pelestedt/NTJ-Locomotive-Control/NTJ-Decoder-PCB/20211014_154324.jpg

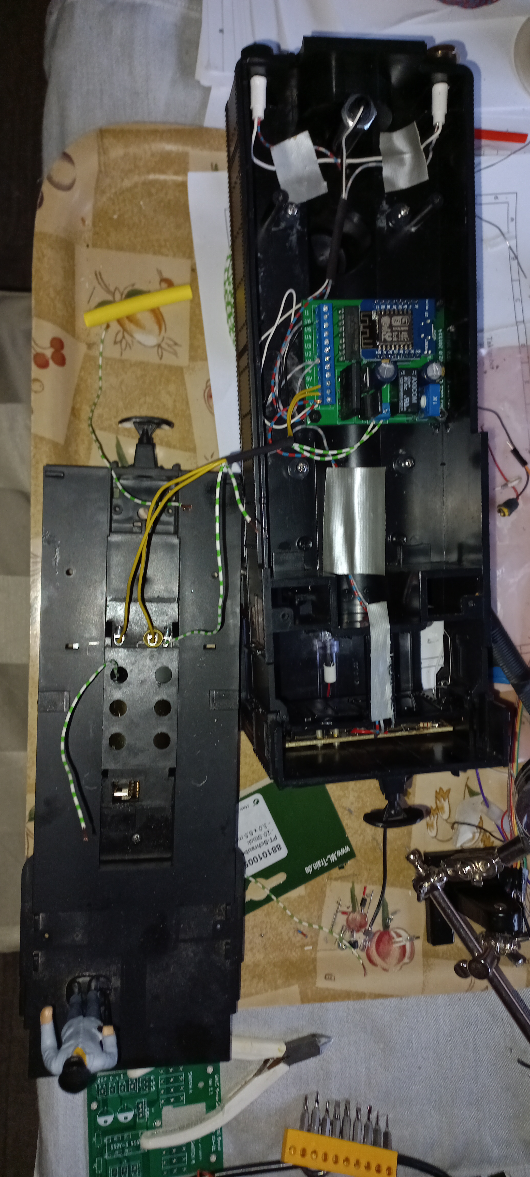
NTJ-Decoder-PCB/20211014_154324.jpg
