pelestedt/NTJ-Locomotive-Control/NTJ_analog_decoder/Inkopppling analogdekoder.pptx

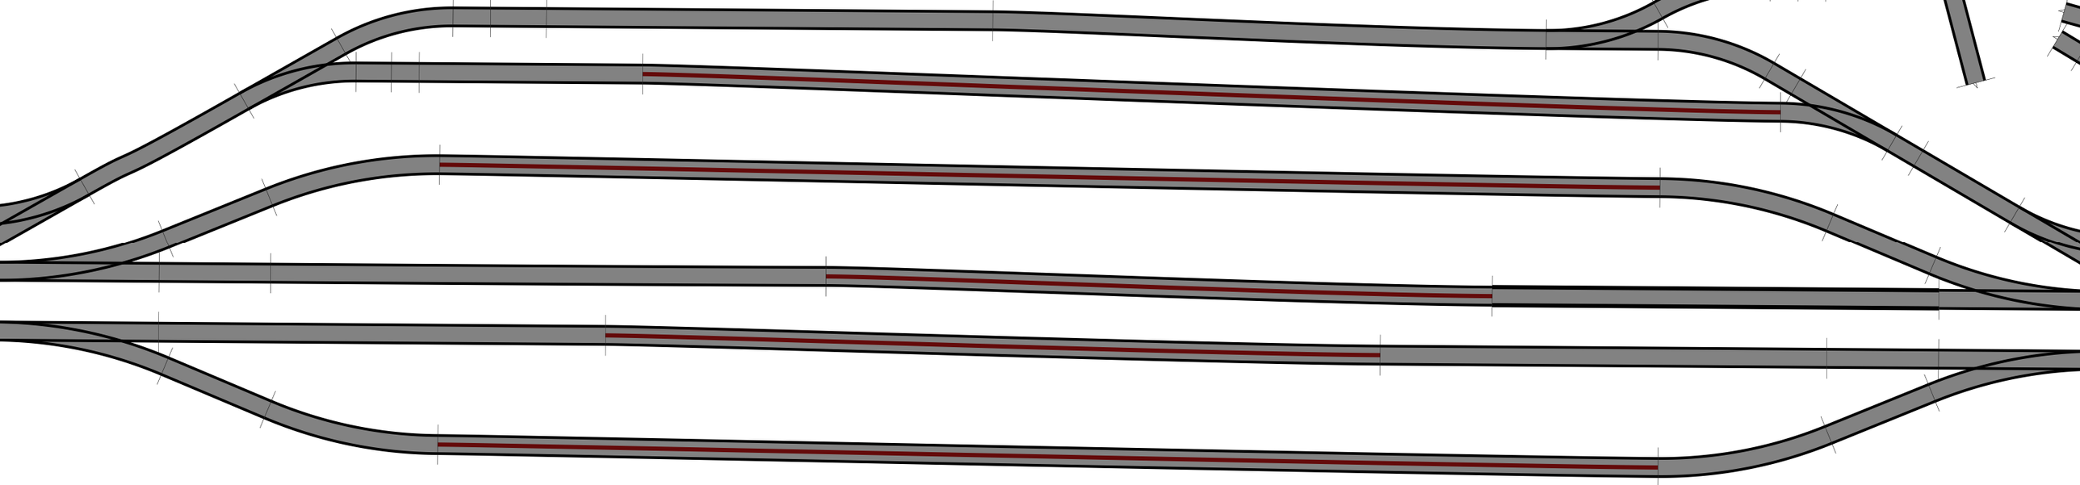
[picture p2: figure]

## Slide 2

220VAC

PSU 22VDC

22VDC

Step down 7VDC

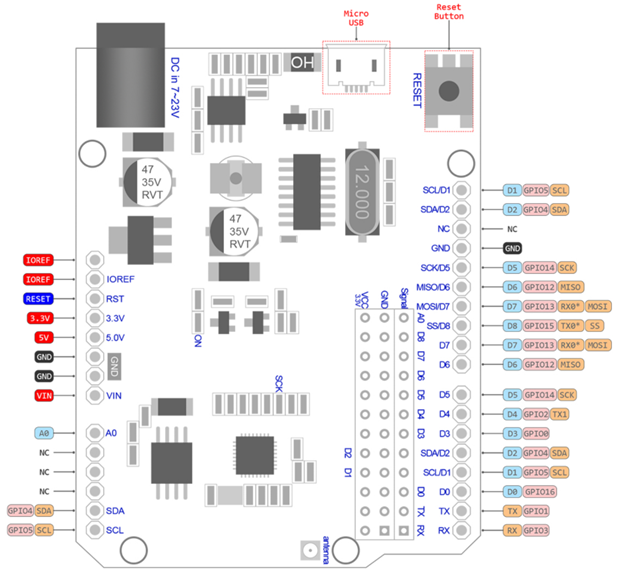
[picture p3: figure]
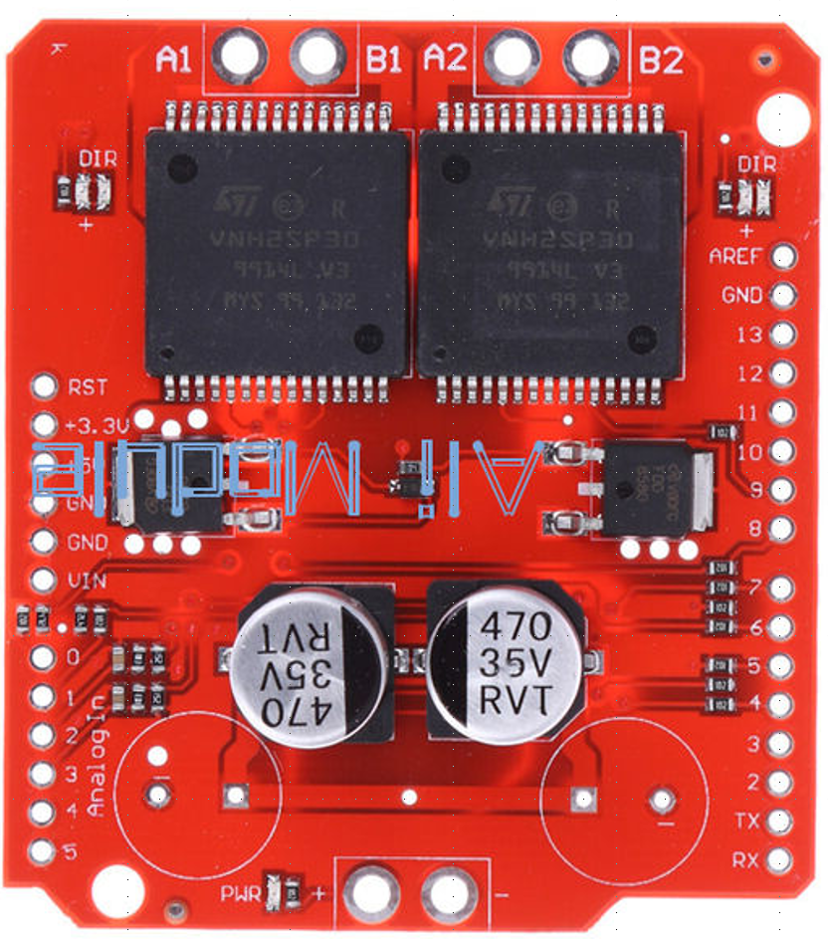
[picture p4: figure]

UT A

UT B

## Slide 3

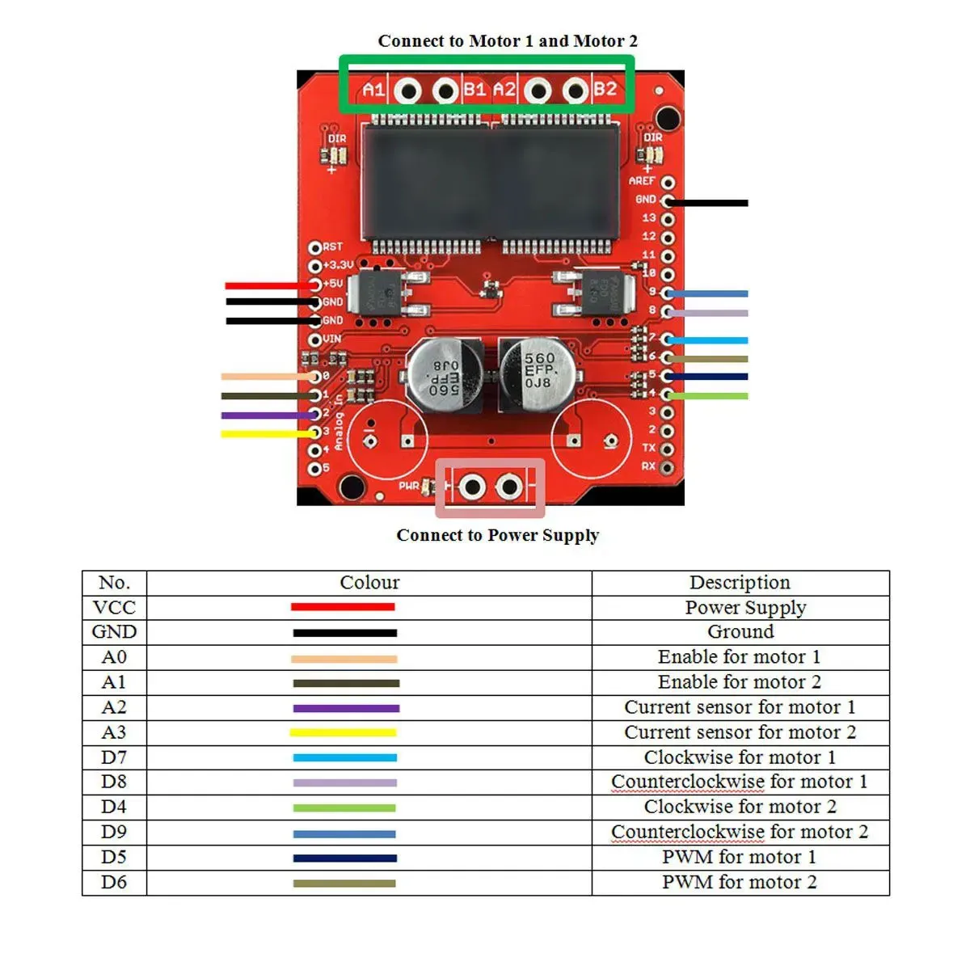
[picture p5: figure]

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
Relä 3

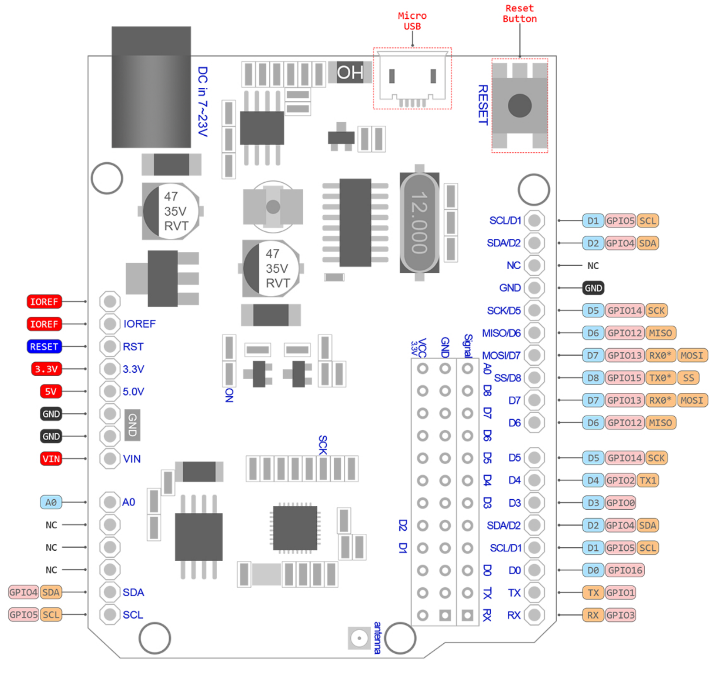
[picture p6: figure]

Relä 4

Relä 2

Relä 1

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
PWMa
PWMb

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
PWMa
PWMb
