pelestedt/NTJ-Locomotive-Control/NTJ-Decoder-PCB/Lokstyrning.kicad_pcb

## KiCad design NTJ-Decoder-PCB/Lokstyrning.kicad_pcb (2024-12-29)

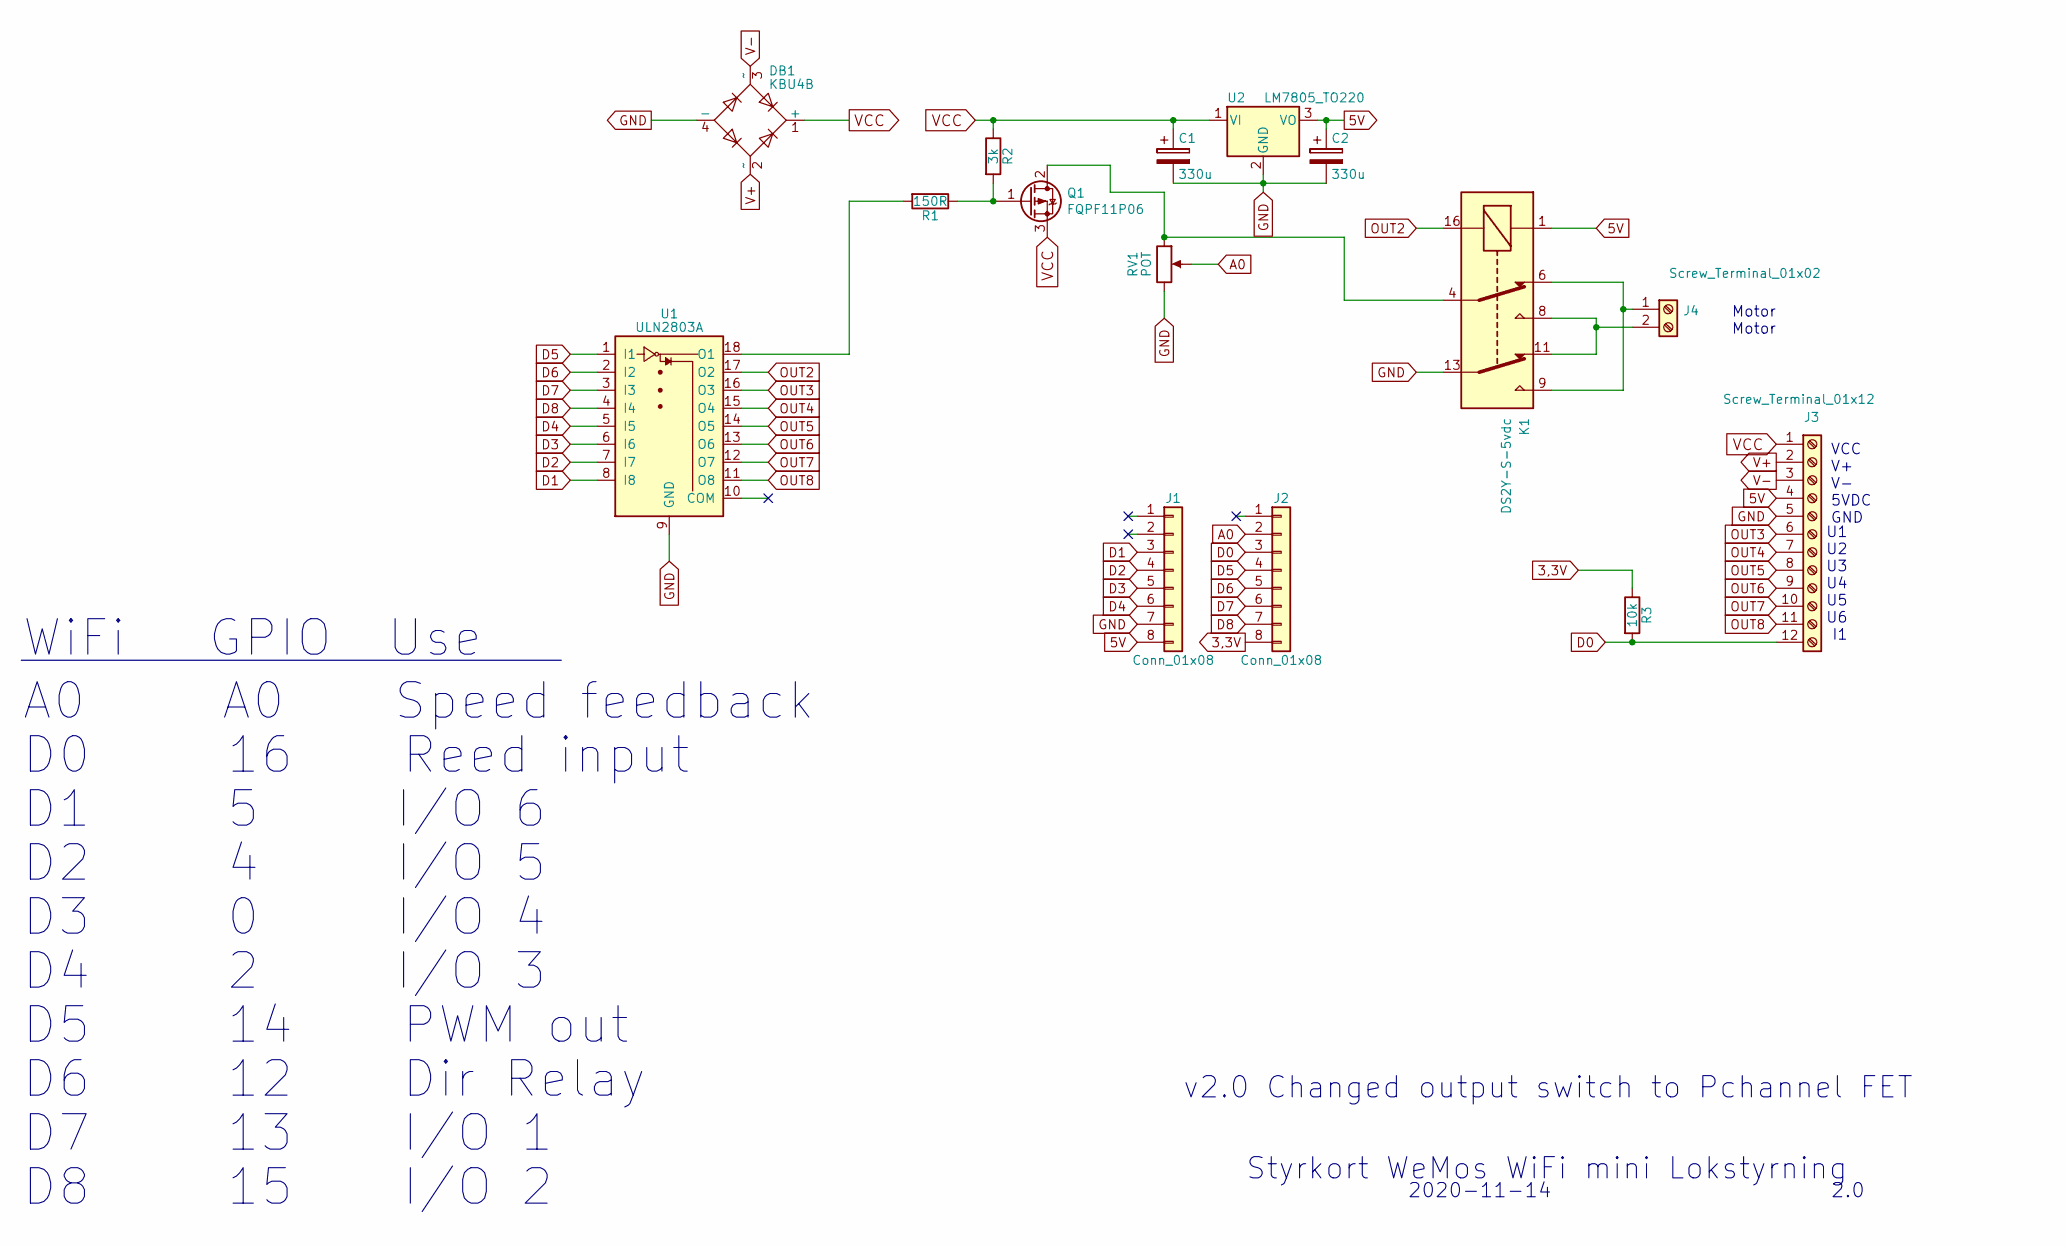
[picture p7: schematic Lokstyrning.sch]

Parts:
C1, C2: 330u; CP_Radial_D8.0mm_P5.00mm
DB1: KBU4B; Diode_Bridge_Vishay_KBU
J1, J2: Conn_01x08; Molex_SPOX-5267_22-03-5085_08x2.54mm_Straight
J3: Screw_Terminal_01x12; WAGO_734_12Pin_Straight_RuggedPads
J4: Screw_Terminal_01x02; WAGO_734_2pin_Straight_RuggedPads
K1: DS2Y-S-5vdc; Relay_SPST_OMRON-G5Q
Q1: FQPF11P06; TO-220_Vertical
R1: 150R; R_Axial_DIN0207_L6.3mm_D2.5mm_P10.16mm_Horizontal
R2: 3k; R_Axial_DIN0207_L6.3mm_D2.5mm_P10.16mm_Horizontal
R3: 10k; R_Axial_DIN0207_L6.3mm_D2.5mm_P10.16mm_Horizontal
RV1: POT; Potentiometer_Trimmer_ACP_CA14h5_Vertical_Px5.0mm_Py10.0mm
U1: ULN2803A; DIP-18_W7.62mm_LongPads
U2: LM7805_TO220; TO-220_Vertical

Connections:
3,3V: J2.8, R3.1
5V: C2.1, J1.8, J3.4, K1.1, U2.3 (VO)
A0: J2.2, RV1.2
D0: J2.3, J3.12, R3.2
D1: J1.3, U1.8 (I8)
D2: J1.4, U1.7 (I7)
D3: J1.5, U1.6 (I6)
D4: J1.6, U1.5 (I5)
D5: J2.4, U1.1 (I1)
D6: J2.5, U1.2 (I2)
D7: J2.6, U1.3 (I3)
D8: J2.7, U1.4 (I4)
GND: C1.2, C2.2, DB1.4 (-), J1.7, J3.5, K1.13, RV1.3, U1.9 (GND), U2.2 (GND)
unnamed: J4.1, K1.6, K1.9
unnamed: J4.2, K1.8, K1.11
unnamed: K1.4, Q1.2 (D), RV1.1
unnamed: Q1.1 (G), R1.1, R2.2
unnamed: R1.2, U1.18 (O1)
OUT2: K1.16, U1.17 (O2)
OUT3: J3.6, U1.16 (O3)
OUT4: J3.7, U1.15 (O4)
OUT5: J3.8, U1.14 (O5)
OUT6: J3.9, U1.13 (O6)
OUT7: J3.10, U1.12 (O7)
OUT8: J3.11, U1.11 (O8)
V+: DB1.2 (~~), J3.2
V-: DB1.3 (~~), J3.3
VCC: C1.1, DB1.1 (+), J3.1, Q1.3 (S), R2.1, U2.1 (VI)

Notes on the sheet:
D0 16 Reed input
D1 5 I/O 6
D2 4 I/O 5
A0 A0 Speed feedback
WiFi GPIO Use
D3 0 I/O 4
D4 2 I/O 3
D5 14 PWM out
D6 12 Dir Relay
D7 13 I/O 1
D8 15 I/O 2
Styrkort WeMos WiFi mini Lokstyrning
2020-11-14
2.0
U1 U2 U3 U4 U5 U6 I1
VCC V+ V- 5VDC GND
Motor Motor
v2.0 Changed output switch to Pchannel FET

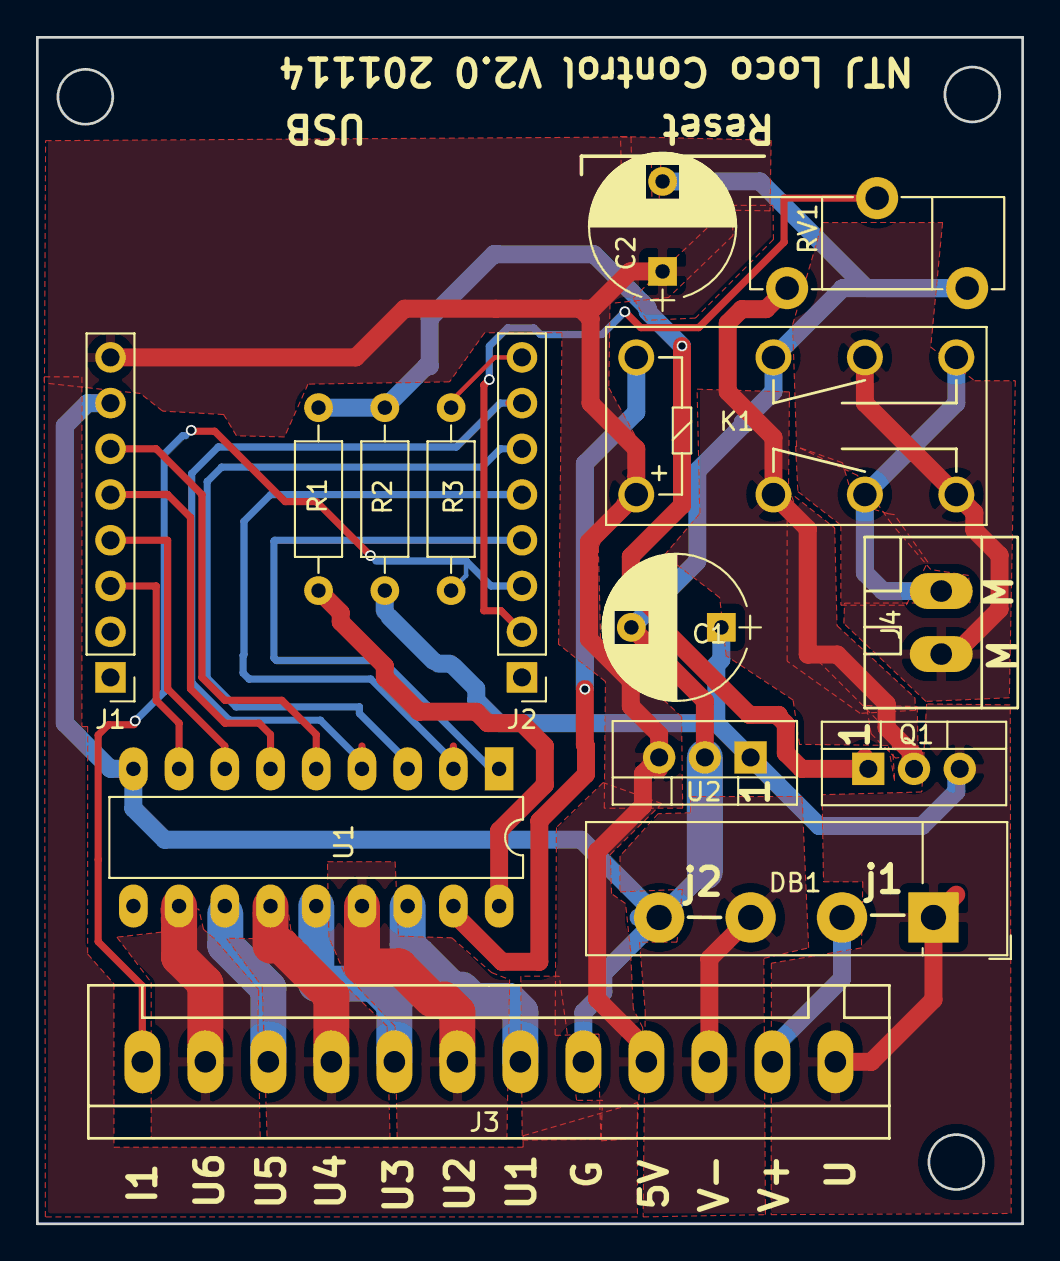
[picture p8: board Lokstyrning.kicad_pcb from above]

Board: 2 copper layers, 54.7 x 65.9 mm, 15 parts (0 on the bottom side), 28 nets.
